williamyang98/16qam_modulator/circuit/qam_transmitter/qam_transmitter.kicad_sch

## KiCad design circuit/qam_transmitter/qam_transmitter.kicad_sch (2022-08-14)

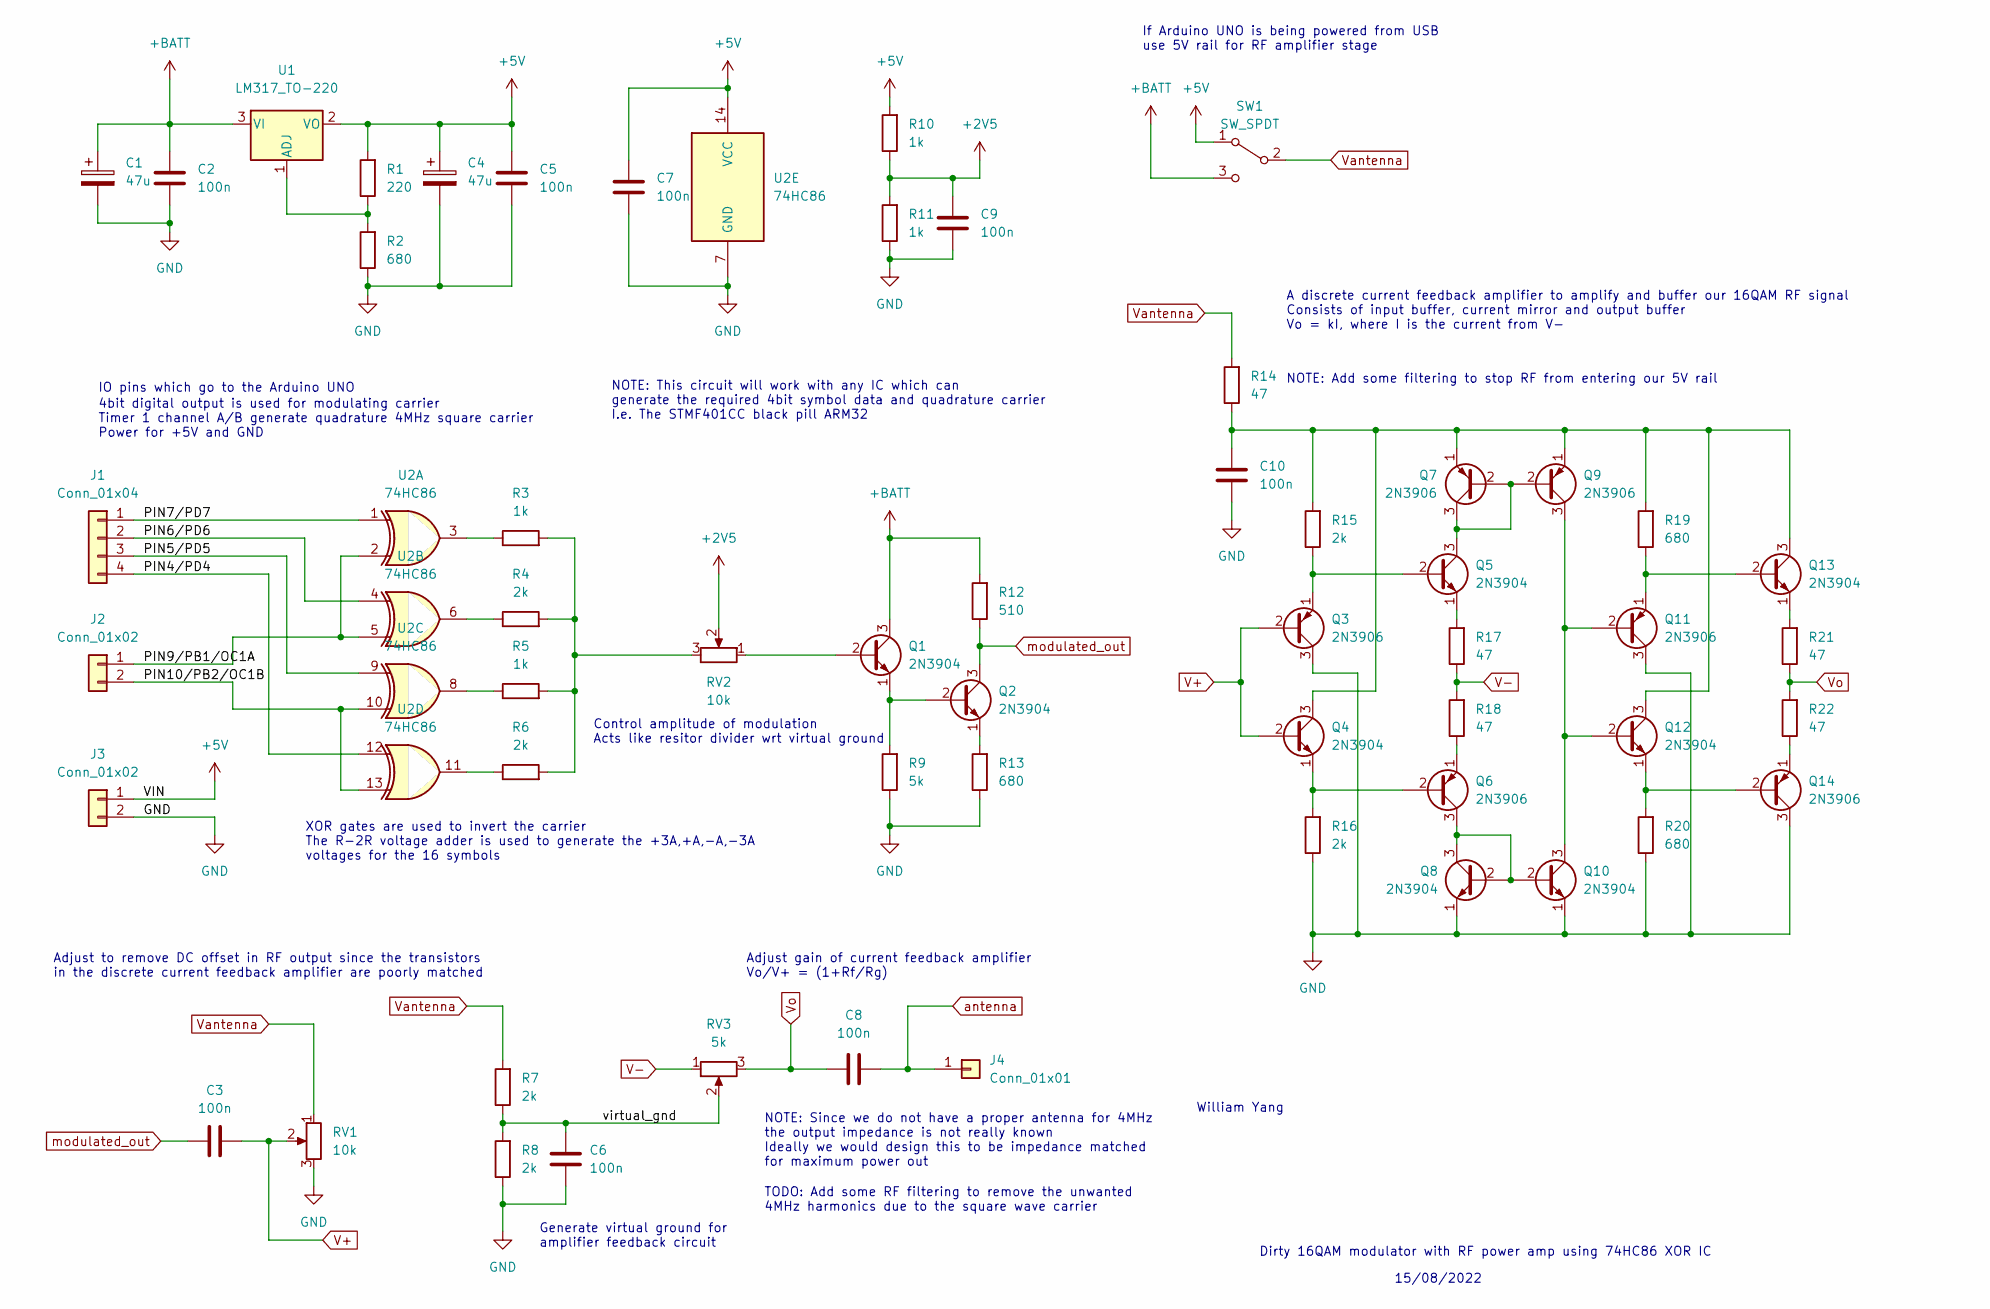
[picture p4: schematic qam_transmitter.kicad_sch]

Parts:
C1, C4: 47u; CP_Radial_D5.0mm_P2.50mm
C2, C3, C5, C6, C7, C8, C9, C10: 100n; C_Disc_D4.7mm_W2.5mm_P5.00mm
J1: Conn_01x04
J2, J3: Conn_01x02
J4: Conn_01x01
Q1, Q2, Q4, Q5, Q8, Q10, Q12, Q13: 2N3904; TO-92_Inline
Q3, Q6, Q7, Q9, Q11, Q14: 2N3906; TO-92_Inline
R1: 220; R_Axial_DIN0207_L6.3mm_D2.5mm_P7.62mm_Horizontal
R2, R13, R19, R20: 680; R_Axial_DIN0207_L6.3mm_D2.5mm_P7.62mm_Horizontal
R3, R5, R10, R11: 1k; R_Axial_DIN0207_L6.3mm_D2.5mm_P7.62mm_Horizontal
R4, R6, R7, R8, R15, R16: 2k; R_Axial_DIN0207_L6.3mm_D2.5mm_P7.62mm_Horizontal
R9: 5k; R_Axial_DIN0207_L6.3mm_D2.5mm_P7.62mm_Horizontal
R12: 510; R_Axial_DIN0207_L6.3mm_D2.5mm_P7.62mm_Horizontal
R14, R17, R18, R21, R22: 47; R_Axial_DIN0207_L6.3mm_D2.5mm_P7.62mm_Horizontal
RV1, RV2: 10k; Potentiometer_ACP_CA9-H5_Horizontal
RV3: 5k; Potentiometer_ACP_CA9-H5_Horizontal
SW1: SW_SPDT
U1: LM317_TO-220; TO-220-3_Vertical
U2: 74HC86

Connections:
+2V5: C9.1, R10.1, R11.2, RV2.2
+5V: C4.1, C5.1, C7.1, J3.1, R1.2, R10.2, SW1.1 (A), U1.2 (VO), U2.14 (VCC)
+BATT: C1.1, C2.1, Q1.3 (C), R12.2, SW1.3 (C), U1.3 (VI)
GND: C1.2, C2.2, C4.2, C5.2, C6.1, C7.2, C9.2, C10.2, J3.2, Q3.3 (C), Q8.1 (E), Q10.1 (E), Q11.3 (C), Q14.3 (C), R2.1, R8.1, R9.1, R11.1, R13.1, R16.1, R20.1, RV1.3, U2.7 (GND)
unnamed: C10.1, Q4.3 (C), Q7.1 (E), Q9.1 (E), Q12.3 (C), Q13.3 (C), R14.1, R15.2, R19.2
unnamed: Q1.1 (E), Q2.2 (B), R9.2
unnamed: Q1.2 (B), RV2.1
unnamed: Q2.1 (E), R13.2
unnamed: Q3.1 (E), Q5.2 (B), R15.1
unnamed: Q4.1 (E), Q6.2 (B), R16.2
unnamed: Q5.1 (E), R17.2
unnamed: Q5.3 (C), Q7.2 (B), Q7.3 (C), Q9.2 (B)
unnamed: Q6.1 (E), R18.1
unnamed: Q6.3 (C), Q8.2 (B), Q8.3 (C), Q10.2 (B)
unnamed: Q9.3 (C), Q10.3 (C), Q11.2 (B), Q12.2 (B)
unnamed: Q11.1 (E), Q13.2 (B), R19.1
unnamed: Q12.1 (E), Q14.2 (B), R20.2
unnamed: Q13.1 (E), R21.2
unnamed: Q14.1 (E), R22.1
unnamed: R1.1, R2.2, U1.1 (ADJ)
unnamed: R3.1, U2.3
unnamed: R3.2, R4.2, R5.2, R6.2, RV2.3
unnamed: R4.1, U2.6
unnamed: R5.1, U2.8
unnamed: R6.1, U2.11
PIN4/PD4: J1.4, U2.12
PIN5/PD5: J1.3, U2.9
PIN6/PD6: J1.2, U2.4
PIN7/PD7: J1.1, U2.1
PIN9/PB1/OC1A: J2.1, U2.2, U2.5
PIN10/PB2/OC1B: J2.2, U2.10, U2.13
V+: C3.2, Q3.2 (B), Q4.2 (B), RV1.2
V-: R17.1, R18.2, RV3.1
Vantenna: R7.2, R14.2, RV1.1, SW1.2 (B)
Vo: C8.2, R21.1, R22.2, RV3.3
antenna: C8.1, J4.1
modulated_out: C3.1, Q2.3 (C), R12.1
virtual_gnd: C6.2, R7.1, R8.2, RV3.2

Notes on the sheet:
NOTE: Since we do not have a proper antenna for 4MHz the output impedance is not really known Ideally we would design this to be impedance matched for maximum power out
A discrete current feedback amplifier to amplify and buffer our 16QAM RF signal Consists of input buffer, current mirror and output buffer Vo = kI, where I is the current from V-
William Yang
Dirty 16QAM modulator with RF power amp using 74HC86 XOR IC
Generate virtual ground for amplifier feedback circuit
Adjust to remove DC offset in RF output since the transistors in the discrete current feedback amplifier are poorly matched
Adjust gain of current feedback amplifier Vo/V+ = (1+Rf/Rg)
15/08/2022
If Arduino UNO is being powered from USB use 5V rail for RF amplifier stage
XOR gates are used to invert the carrier The R-2R voltage adder is used to generate the +3A,+A,-A,-3A voltages for the 16 symbols
Control amplitude of modulation Acts like resitor divider wrt virtual ground
4bit digital output is used for modulating carrier Timer 1 channel A/B generate quadrature 4MHz square carrier Power for +5V and GND
IO pins which go to the Arduino UNO
TODO: Add some RF filtering to remove the unwanted 4MHz harmonics due to the square wave carrier
NOTE: This circuit will work with any IC which can generate the required 4bit symbol data and quadrature carrier I.e. The STMF401CC black pill ARM32
NOTE: Add some filtering to stop RF from entering our 5V rail
