williamyang98/16qam_modulator/transmitter/stm32f401/16qam_transmitter.ioc

Mcu.UserName=STM32F401CCUx
PA1.Signal=S_TIM2_CH2
PA2.Signal=USART2_TX
PA5.Signal=S_TIM2_CH1_ETR
PA6.Signal=S_TIM3_CH1
PA8.Signal=S_TIM1_CH1
PB1.Signal=ADCx_IN9
PB4.Signal=GPIO_Output
PB5.Signal=GPIO_Output
PB6.Signal=GPIO_Output
PB7.Signal=GPIO_Output
PB8.GPIO_Label=ENCODE_FLAG_OUT
PB8.Signal=GPIO_Output
PB9.GPIO_Label=TX_SYM_FLAG_OUT
PB9.Signal=GPIO_Output
PC13-ANTI_TAMP.GPIO_Label=LED
PC13-ANTI_TAMP.Signal=GPIO_Output
PC14-OSC32_IN.Signal=RCC_OSC32_IN
PC15-OSC32_OUT.Signal=RCC_OSC32_OUT
