williamyang98/16qam_modulator/transmitter/stm32f401/Core/Src/main.c

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
/* Includes ------------------------------------------------------------------*/
#include "main.h"

/* USER CODE BEGIN Includes */
#include "crc8.h"
#include "conv_enc.h"
#include "scrambler.h"
/* USER CODE END Includes */

/* USER CODE BEGIN PD */
#define ADC_BUFFER_LENGTH 100
#define TX_SYM_BUFFER_LENGTH 250
/* USER CODE END PD */

ADC_HandleTypeDef hadc1;
DMA_HandleTypeDef hdma_adc1;

CRC_HandleTypeDef hcrc;

TIM_HandleTypeDef htim1;
TIM_HandleTypeDef htim2;
TIM_HandleTypeDef htim3;

UART_HandleTypeDef huart2;

/* USER CODE BEGIN PV */
// Circular buffer for ADC reading
uint16_t ADC_BUFFER[ADC_BUFFER_LENGTH*2] = {0};
// We unpack the 16QAM symbols into 4bit chunks
// Read as a circular buffer that is reset by ADC ISR
uint8_t TX_SYM_BUFFER[TX_SYM_BUFFER_LENGTH*2*2] = {0};

// We encode our data into this buffer before we unpack it into TX_SYM_BUFFER
uint8_t ENCODING_SCRATCH_BUFFER[TX_SYM_BUFFER_LENGTH] = {0};
// We convert our ADC readings into 8bit for encoding
uint8_t ADC_SCRATCH_BUFFER[ADC_BUFFER_LENGTH] = {0};

// Generate gray code for better FEC
uint8_t GRAY_CODE[16] = {0};

// Start from the second buffer for symbol transmit
// We alternate between halves of the ADC/TX_SYM buffer for double buffered processing
volatile int tx_sym_buffer_index = TX_SYM_BUFFER_LENGTH*2;
volatile int is_half_buffer_ready = 0;
volatile int is_full_buffer_ready = 0;

const uint32_t PREAMBLE_CODE = 0b11111001101011111100110101101101;
const uint16_t SCRAMBLER_CODE = 0b1000010101011001;
const uint8_t CRC8_POLY = 0xD5;
/* USER CODE END PV */

void SystemClock_Config(void);
static void MX_GPIO_Init(void);
static void MX_DMA_Init(void);
static void MX_ADC1_Init(void);
static void MX_USART2_UART_Init(void);
static void MX_TIM2_Init(void);
static void MX_CRC_Init(void);
static void MX_TIM3_Init(void);
static void MX_TIM1_Init(void);
/* USER CODE BEGIN PFP */
static void user_init(void);
static int generate_packet(uint8_t* x, const int N, uint8_t* y);
static void adc_buffer_convert(uint16_t* x, uint8_t* y, const int N);
static void qam_symbol_unpack(uint8_t* x, uint8_t* y, const int N);
/* USER CODE END PFP */

/* USER CODE BEGIN 0 */
void user_init(void) {
	crc8_generate_table(CRC8_POLY);
	conv_enc_calculate_table(0b111, 0b101);
	scrambler_init(SCRAMBLER_CODE);

	tx_sym_buffer_index = TX_SYM_BUFFER_LENGTH*2;

	// generate gray code for 2D
	uint8_t _gray_code[4] = {0b00, 0b01, 0b11, 0b10}; // 1D gray code
	for (uint8_t i = 0; i < 4; i++) {
		for (uint8_t q = 0; q < 4; q++) {
			uint8_t I = _gray_code[i];
			uint8_t Q = _gray_code[q];
			uint8_t idx = (i<<2) | q;
			uint8_t sym = (I<<2) | Q;
			// shift by 4 bits to align with output pins
			GRAY_CODE[idx] = sym;
		}
	}
}

// Our encoding pipeline
int generate_packet(uint8_t* x, const int N, uint8_t* y) {
	conv_enc_reset();
	scrambler_reset();

	// We cast this to uint16_t so we can write the trellis terminator along with it
	// NOTE: this uses a big endian notation so the null byte is located correctly without a shift
	uint8_t crc8 = crc8_calculate(x, N);
	uint8_t trellis_terminator = 0x00;
	uint16_t len = (uint16_t)(N);

	int offset = 0;
	// NOTE: We are generating this before hand to save a few instructions
	y[0] = (PREAMBLE_CODE >> 24) & 0xFF;
	y[1] = (PREAMBLE_CODE >> 16) & 0xFF;
	y[2] = (PREAMBLE_CODE >> 8 ) & 0xFF;
	y[3] = (PREAMBLE_CODE      ) & 0xFF;
	offset += 4;

	int scrambler_start = offset;

	// Encode then scramble the output
	offset += conv_enc_process((uint8_t*)(&len),	&y[offset], 2);
	offset += conv_enc_process(x,					&y[offset], N);
	offset += conv_enc_process(&crc8,				&y[offset], 1);
	offset += conv_enc_process(&trellis_terminator,	&y[offset], 1);

	int scrambler_end = offset;

	for (int i = scrambler_start; i < scrambler_end; i++) {
		y[i] = scrambler_process(y[i]);
	}

	return offset;
}

void adc_buffer_convert(uint16_t* x, uint8_t* y, const int N) {
	for (int i = 0; i < N; i++) {
		y[i] = x[i];
	}
}

void qam_symbol_unpack(uint8_t* x, uint8_t* y, const int N) {
	int j = 0;
	for (int i = 0; i < N; i++) {
		y[j++] = GRAY_CODE[x[i] >> 4];
		y[j++] = GRAY_CODE[x[i] & 0x0F];
	}
}
/* USER CODE END 0 */

/**
  * @brief  The application entry point.
  * @retval int
  */
int main(void)
{
  /* USER CODE BEGIN 1 */
	user_init();
  /* USER CODE END 1 */

  /* MCU Configuration--------------------------------------------------------*/

  /* Reset of all peripherals, Initializes the Flash interface and the Systick. */
  HAL_Init();

  /* Configure the system clock */
  SystemClock_Config();

  /* Initialize all configured peripherals */
  MX_GPIO_Init();
  MX_DMA_Init();
  MX_ADC1_Init();
  MX_USART2_UART_Init();
  MX_TIM2_Init();
  MX_CRC_Init();
  MX_TIM3_Init();
  MX_TIM1_Init();
  /* USER CODE BEGIN 2 */
  HAL_TIM_OC_Start(&htim1, TIM_CHANNEL_1);
  HAL_TIM_OC_Start(&htim2, TIM_CHANNEL_1);
  HAL_TIM_OC_Start(&htim2, TIM_CHANNEL_2);
  HAL_TIM_OC_Start(&htim3, TIM_CHANNEL_1);

  // Circular buffer for adc reading
  HAL_ADC_Start_DMA(&hadc1, (uint32_t*)ADC_BUFFER, ADC_BUFFER_LENGTH*2);

  HAL_TIM_Base_Start_IT(&htim1);

  // Define the halves of our ADC and TX_SYM buffer
  uint16_t* ADC_BUFFER_0 = &ADC_BUFFER[0];
  uint16_t* ADC_BUFFER_1 = &ADC_BUFFER[ADC_BUFFER_LENGTH];
  uint8_t*  TX_SYM_BUFFER_0 = &TX_SYM_BUFFER[0];
  uint8_t*  TX_SYM_BUFFER_1 = &TX_SYM_BUFFER[TX_SYM_BUFFER_LENGTH*2];
  uint8_t SAMPLE_MESSAGE[13] = {0};
  for (uint8_t i = 0; i < 13; i++) {
	  SAMPLE_MESSAGE[i] = 'a'+i;
  }

  int offset = 0;
  /* USER CODE END 2 */

  /* Infinite loop */
  /* USER CODE BEGIN WHILE */
  while (1)
  {
    /* USER CODE END WHILE */

    /* USER CODE BEGIN 3 */

	// adc:		  writes to second half of ADC_BUFFER
	// tx_isr:    reads from first half of TX_BUFFER
	// main_loop: reads from first half of ADC_BUFFER
	//			  writes to second half of TX_BUFFER
	while (!is_half_buffer_ready);
	is_half_buffer_ready = 0;

	HAL_GPIO_WritePin(ENCODE_FLAG_OUT_GPIO_Port, ENCODE_FLAG_OUT_Pin, GPIO_PIN_SET);

	offset = 0;
	adc_buffer_convert(ADC_BUFFER_0, ADC_SCRATCH_BUFFER, ADC_BUFFER_LENGTH);
	offset += generate_packet(ADC_SCRATCH_BUFFER, ADC_BUFFER_LENGTH, &ENCODING_SCRATCH_BUFFER[offset]);
	offset += generate_packet(SAMPLE_MESSAGE, 13, &ENCODING_SCRATCH_BUFFER[offset]);
	qam_symbol_unpack(ENCODING_SCRATCH_BUFFER, TX_SYM_BUFFER_1, TX_SYM_BUFFER_LENGTH);

	HAL_GPIO_WritePin(ENCODE_FLAG_OUT_GPIO_Port, ENCODE_FLAG_OUT_Pin, GPIO_PIN_RESET);

	// adc:		  writes to first half of ADC_BUFFER
	// tx_isr:    reads from second half of TX_BUFFER
	// main_loop: reads from second half of ADC_BUFFER
	//			  writes to first half of TX_BUFFER
	while (!is_full_buffer_ready);
	is_full_buffer_ready = 0;

	HAL_GPIO_WritePin(ENCODE_FLAG_OUT_GPIO_Port, ENCODE_FLAG_OUT_Pin, GPIO_PIN_SET);

	offset = 0;
	adc_buffer_convert(ADC_BUFFER_1, ADC_SCRATCH_BUFFER, ADC_BUFFER_LENGTH);
	offset += generate_packet(ADC_SCRATCH_BUFFER, ADC_BUFFER_LENGTH, &ENCODING_SCRATCH_BUFFER[offset]);
	offset += generate_packet(SAMPLE_MESSAGE, 13, &ENCODING_SCRATCH_BUFFER[offset]);
	qam_symbol_unpack(ENCODING_SCRATCH_BUFFER, TX_SYM_BUFFER_0, TX_SYM_BUFFER_LENGTH);

	HAL_GPIO_WritePin(ENCODE_FLAG_OUT_GPIO_Port, ENCODE_FLAG_OUT_Pin, GPIO_PIN_RESET);
  }
  /* USER CODE END 3 */
}

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
/* USER CODE BEGIN 4 */
// adc:		  writes to second half of ADC_BUFFER
// tx_isr:    reads from first half of TX_BUFFER
// main_loop: reads from first half of ADC_BUFFER
//			  writes to second half of TX_BUFFER
void HAL_ADC_ConvHalfCpltCallback(ADC_HandleTypeDef* hadc) {
	//tx_sym_buffer_index = 0;
	is_half_buffer_ready = 1;
	HAL_GPIO_WritePin(LED_GPIO_Port, LED_Pin, GPIO_PIN_SET);
}

// adc:		  writes to first half of ADC_BUFFER
// tx_isr:    reads from second half of TX_BUFFER
// main_loop: reads from second half of ADC_BUFFER
//			  writes to first half of TX_BUFFER
void HAL_ADC_ConvCpltCallback(ADC_HandleTypeDef* hadc) {
	is_full_buffer_ready = 1;
	HAL_GPIO_WritePin(LED_GPIO_Port, LED_Pin, GPIO_PIN_RESET);
}

void HAL_TIM_PeriodElapsedCallback(TIM_HandleTypeDef *htim) {
	//HAL_GPIO_TogglePin(GPIOB, GPIO_PIN_4|GPIO_PIN_5|GPIO_PIN_6|GPIO_PIN_7);
	HAL_GPIO_WritePin(TX_SYM_FLAG_OUT_GPIO_Port, TX_SYM_FLAG_OUT_Pin, GPIO_PIN_SET);

	// b now is equivalent to GPIO_PIN_4|GPIO_PIN_5|GPIO_PIN_6|GPIO_PIN_7
	const uint8_t b = TX_SYM_BUFFER[tx_sym_buffer_index];
	const uint8_t b_set = b << 4;
	const uint8_t b_reset = ~b << 4;
	const uint32_t v = ((uint32_t)b_reset << 16) | (uint32_t)(b_set);
	// 0xFFFF0000 resets pin, 0x0000FFFF sets pin
	GPIOB->BSRR = v;
	tx_sym_buffer_index = (tx_sym_buffer_index+1) % (TX_SYM_BUFFER_LENGTH*2*2);
	//tx_sym_buffer_index++;

	HAL_GPIO_WritePin(TX_SYM_FLAG_OUT_GPIO_Port, TX_SYM_FLAG_OUT_Pin, GPIO_PIN_RESET);
}

/* USER CODE END 4 */
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
