williamyang98/16qam_modulator/transmitter/stm32f401/Core/Inc/main.h

#define LED_Pin GPIO_PIN_13
#define LED_GPIO_Port GPIOC
#define ENCODE_FLAG_OUT_Pin GPIO_PIN_8
#define ENCODE_FLAG_OUT_GPIO_Port GPIOB
#define TX_SYM_FLAG_OUT_Pin GPIO_PIN_9
#define TX_SYM_FLAG_OUT_GPIO_Port GPIOB
