williamyang98/16qam_modulator/receiver/src/decoder/frame_decoder.cpp

#include "frame_decoder.h"
#include <assert.h>

#include "preamble_detector.h"
#include "additive_scrambler.h"
#include "viterbi_decoder.h"
#include "crc8.h"

FrameDecoder::FrameDecoder(
    const int _buffer_size, 
    ConstellationSpecification& _constellation,
    const uint32_t preamble_word,
    const uint16_t scrambler_syncword, 
    const uint8_t conv_poly[2],
    const uint8_t crc8_poly)
: buffer_size(_buffer_size),
  constellation(_constellation)
{
    state = State::WAIT_BLOCK_SIZE;

    constexpr int TOTAL_PHASES = 4;
    preamble_detector = std::make_unique<PreambleDetector>(preamble_word, TOTAL_PHASES);
    descrambler = std::make_unique<AdditiveScrambler>(scrambler_syncword);

    vitdec = std::make_unique<ViterbiDecoder>(conv_poly, buffer_size*8);
    crc8_calc = std::make_unique<CRC8_Calculator>(crc8_poly);

    descramble_buffer.resize(buffer_size);
    encoded_buffer.resize(buffer_size);
    decoded_buffer.resize(buffer_size);
}

FrameDecoder::~FrameDecoder() = default;

FrameDecoder::ProcessResult FrameDecoder::process(const std::complex<float> IQ) {
    if (state == State::WAIT_PREAMBLE) {
        return process_await_preamble(IQ);
    }

    const auto phase_shift = preamble_detector->GetPhase();
    const uint8_t x = constellation.GetNearestSymbol(IQ * phase_shift);
    const int nb_bits = constellation.GetBitsPerSymbol();

    auto res = ProcessResult::NONE;
    switch (state) {
    case State::WAIT_BLOCK_SIZE:
        return process_await_block_size(x, nb_bits);
        break;
    case State::WAIT_PAYLOAD:
        return process_await_payload(x, nb_bits);
        break;
    default:
        return ProcessResult::NONE;
    }
}

FrameDecoder::ProcessResult FrameDecoder::process_await_preamble(const std::complex<float> IQ) {
    auto res = preamble_detector->Process(IQ, constellation);
    if (!res) {
        return ProcessResult::NONE;
    }

    state = State::WAIT_BLOCK_SIZE;
    payload.reset();
    return ProcessResult::PREAMBLE_FOUND;
}

FrameDecoder::ProcessResult FrameDecoder::process_await_block_size(const uint8_t x, const int nb_bits) {
    process_decoder_bits(x, nb_bits);

    // Get block size once we have enough bytes decoded
    bool is_done = 
        (encoded_bytes >= nb_bytes_for_block_size) &&
        (encoded_bits == 0);
    
    if (!is_done) {
        return ProcessResult::NONE;
    }

    const int nb_decoded_bytes = nb_bytes_for_block_size/CODE_RATE;
    assert(nb_bytes_for_block_size <= buffer_size);
    assert(nb_decoded_bytes <= buffer_size );

    vitdec->Update({ &encoded_buffer[0], (size_t)nb_bytes_for_block_size });
    vitdec->GetTraceback({ &decoded_buffer[0], (size_t)nb_decoded_bytes });
    decoded_bytes += nb_decoded_bytes;

    const uint16_t rx_block_size = *reinterpret_cast<uint16_t*>(&decoded_buffer[0]);
    payload.length = rx_block_size;

    constexpr int frame_overhead = 2+1+1; // 2byte length and crc8 and null terminator

    // our receiving block size must fit into the buffer with length and crc
    const int min_block_size = nb_bytes_for_block_size/2 - 3;
    const int max_block_size = buffer_size/CODE_RATE - frame_overhead;

    if ((rx_block_size > max_block_size) || (rx_block_size < min_block_size)) {
        state = State::WAIT_PREAMBLE; 
        reset();
        payload.buf = NULL; 
        return ProcessResult::BLOCK_SIZE_ERR;
    } else {
        payload.buf = NULL;
        decoded_block_size = rx_block_size;
        encoded_block_size = CODE_RATE*(decoded_block_size+frame_overhead);
        state = State::WAIT_PAYLOAD; 
        return ProcessResult::BLOCK_SIZE_OK;
    }
}

FrameDecoder::ProcessResult FrameDecoder::process_await_payload(const uint8_t x, const int nb_bits) {
    process_decoder_bits(x, nb_bits);
    bool is_done = 
        (encoded_bytes >= encoded_block_size) &&
        (encoded_bits == 0);

    if (!is_done) {
        return ProcessResult::NONE;
    }

    // Once we have received the known number of encoded bytes, decode the rest of the frame
    // We flush the viterbi decoder to get all of the predicted bits
    // NOTE: We have a known byte of 0x00 as the Trellis terminator
    const int nb_encoded_bytes = encoded_block_size-nb_bytes_for_block_size;
    const int nb_decoded_bytes = nb_encoded_bytes/CODE_RATE;

    assert(nb_encoded_bytes <= buffer_size);
    assert((encoded_block_size/CODE_RATE) <= buffer_size);

    vitdec->Update({ &encoded_buffer[nb_bytes_for_block_size], (size_t)nb_encoded_bytes });
    vitdec->GetTraceback({ &decoded_buffer[0], (size_t)(encoded_block_size/CODE_RATE) });
    decoded_bytes += nb_decoded_bytes;

    assert(decoded_bytes <= buffer_size);

    // packet structure
    // 0:1 -> uint16_t length
    // 2:2+N -> uint8_t* payload
    // Let K = 2+N+1
    // K:K -> uint8_t crc8
    // K+1:K+1 -> uint8_t trellis null terminator 
    constexpr int frame_length_field_size = 2;
    const int crc8_length = 1;
    const int trellis_terminator_length = 1;

    uint8_t* payload_buf = &decoded_buffer[frame_length_field_size];

    const uint8_t crc8_true = decoded_buffer[decoded_bytes-(crc8_length+trellis_terminator_length)];
    const uint8_t crc8_pred = crc8_calc->process(payload_buf, decoded_block_size);
    const auto dist_err = (int)vitdec->GetPathError();
    const bool crc8_mismatch = (crc8_true != crc8_pred);

    state = State::WAIT_PREAMBLE;
    reset();

    payload.buf = payload_buf;
    payload.crc8_calculated = crc8_pred;
    payload.crc8_received = crc8_true;
    payload.crc8_mismatch = crc8_mismatch;
    payload.decoded_error = dist_err;

    if (crc8_mismatch) {
        return ProcessResult::PAYLOAD_ERR;
    } else {
        return ProcessResult::PAYLOAD_OK;
    }
}

void FrameDecoder::process_decoder_bits(const uint8_t x, const int nb_bits) {
    if (encoded_bits == 0) {
        descramble_buffer[encoded_bytes] = 0;
    }

    const int shift = 8-encoded_bits-nb_bits;
    descramble_buffer[encoded_bytes] |= (x << shift);
    encoded_bits += nb_bits;
    
    // if a byte has been processed, then unscramble and move onto next byte
    if (encoded_bits == 8) {
        encoded_bits = 0;
        encoded_buffer[encoded_bytes] = descrambler->process(descramble_buffer[encoded_bytes]);
        encoded_bytes += 1;
    }

    assert(encoded_bytes <= buffer_size);
}

void FrameDecoder::reset() {
    encoded_bits = 0;
    encoded_bytes = 0;
    decoded_bytes = 0;

    decoded_block_size = 0;
    encoded_block_size = 0;

    descrambler->reset();
    vitdec->Reset();
}
