williamyang98/16qam_modulator/receiver/src/decoder/phil_karn_viterbi_decoder.h

// Phil Karn's Viterbi decoder implementation
// Source: https://github.com/zleffke/libfec
// SSE2 intrinsics are used to improve the performance by up to 8 times

#pragma once

#include <stdint.h>

struct vitdec_t;

#define CONSTRAINT_LENGTH 3
#define CODE_RATE 2
#define DECISIONTYPE uint8_t
#define DECISIONTYPE_BITSIZE 8 
#define COMPUTETYPE int16_t
// If we want to divide the soft decision error
#define METRICSHIFT 0
#define PRECISIONSHIFT 0
// Constants used
#define RENORMALIZE_THRESHOLD   (SHRT_MAX-3000) // If the error starts to overflow, reduce it to this
#define INITIAL_START_ERROR     0        // Initial error of initial state
#define INITIAL_NON_START_ERROR (0+3000) // Initial error of non-initial states

vitdec_t* create_viterbi(
    const uint8_t polys[CODE_RATE], const int len, 
    const COMPUTETYPE soft_decision_high, const COMPUTETYPE soft_decision_low);

void delete_viterbi(vitdec_t* vp);
void init_viterbi(vitdec_t* vp, int starting_state);

// Scalar code: 1x speed
void update_viterbi_blk_scalar(vitdec_t* vp, const COMPUTETYPE* syms, const int nbits);

/* Viterbi chainback */
void chainback_viterbi(
    vitdec_t* const vp,
    unsigned char* data,            /* Decoded output data */
    const unsigned int nbits,       /* Number of data bits */
    const unsigned int endstate);   /* Terminal encoder state */

/* Viterbi chainback without known endstate */
void chainback_viterbi(
    vitdec_t* const vp,
    unsigned char* data,            /* Decoded output data */
    const unsigned int nbits);      /* Number of data bits */

COMPUTETYPE get_error_viterbi(vitdec_t* vp, const int state);
