williamyang98/16qam_modulator/(commit log)

2022-08-13 Initial commit of working prototype
2022-08-14 Added circuit diagram in kicad
    [qam_transmitter.kicad_pcb, qam_transmitter.kicad_sch]
2022-08-16 Updated loop filters and N level crossing
2022-08-22 Added 7bit lookup table for conv encoder
2022-08-22 Flushing traceback considers trellis termination
2022-08-23 Added fir and iir filter designer
2022-08-23 Refactored out preamble filter
2022-08-23 Refactored frame synchronizer into smaller classes
2022-08-24 Fixed bug where FIR filter cannot do inplace
2022-08-24 Fixed preamble filter desync bitcount calculation
    [preamble_filter.h]
2022-08-24 Updated sampling script with lower sample rate
2022-08-27 Added stm32f401 transmitter code
2022-08-27 Added notch filter designer
2022-08-27 Added buffers for tapping off AGC and AC filter output
2022-08-27 Added notch filter to audio processor
2022-08-27 Updated scripts with notch filter
2022-08-27 Updated README for STM32F401
2022-08-28 Changed ADC input to be further from RF out pins
2022-08-28 Timer 1 outputs on channel 1
2022-09-01 Added polyphase filters for multirate processing
2022-09-18 Fixed memory leak with filter specs
2022-09-18 Fixed y axis limits of raw and downsampled signals
2022-09-22 Close demodulator thread when GUI is closed
2023-01-04 Only reset decisions which were modified
    [phil_karn_viterbi_decoder.cpp]
2023-01-04 Corrected DC offsets in receiver and transmitter
    [carrier_demodulator_spec.h]
2023-12-19 Added dev environment setup instructions for stm32
2023-12-29 Fixed compile on linux
    [qam_sync.cpp, qam_sync_buffers.cpp]
