williamyang98/16qam_modulator/(notices)

Notices in the files:
transmitter/stm32f401/Core/Inc/main.h:
Copyright (c) 2022 STMicroelectronics.
All rights reserved.
This software is licensed under terms that can be found in the LICENSE file
